venik/gps_project/doc/diplom_alex/text/diplom_task.tex

\begin{titlepage}
\newpage

\input{titles_head}		% add header

\begin{center}
\vspace{0.5cm}
\fontsize{14pt}{14.5pt}{\fontseries{b}\selectfont{ЗАДАНИЕ НА ДИПЛОМНЫЙ ПРОЕКТ} } \\
\end{center}

\begin{flushleft}
Дипломник
%\so{Никифоров}
\hrulefill \\
шифр\rule{5cm}{0.5pt} группа\rule{3cm}{0.5pt} отделение\rule{1cm}{0.5pt}\textit{дневное}\hrulefill \\

\textbf{Тема проекта}\hrulefill \\
\hrulefill \\
\hrulefill \\
\hrulefill \\
\end{flushleft}

\begin{flushleft}
Утверждена приказом по МГУПИ №\rule{2cm}{0.5pt} от «\rule{2cm}{0.5pt}»\rule{2.65cm}{0.5pt}2010г. \\
Срок представления к защите«\rule{2cm}{0.5pt}»\rule{7cm}{0.5pt}2010г. \\
\end{flushleft}

\begin{flushleft}
\textbf{Техническое задание}
\fontsize{8pt}{4.05pt}{\selectfont{(цель и постановка задачи, исходные данные для проектирования)} } \\
\hrulefill \\
\hrulefill \\
\hrulefill \\
\end{flushleft}

\begin{flushleft}
\textbf{Содержание рассчетно-пояснительной записки} \\
\textbf{Введение}
\fontsize{8pt}{8.05pt}{\selectfont{(обоснование актуальности темы)} }\hrulefill \\
\hrulefill \\
\hrulefill \\
\end{flushleft}

\begin{flushleft}
\textbf{1. Исследовательский раздел}
\fontsize{8pt}{1pt}{\selectfont{(материал по исследованию предметной области, предмета проектирования,
анализ вариантов решения задач, выбор конкретного варианта)} } \\
1.1\hrulefill \\
1.2\hrulefill \\
\end{flushleft}

\begin{flushleft}
\textbf{2. Специальный раздел}
\fontsize{8pt}{8.05pt}{\selectfont{(раскрываются все аспекты проектируемой области)} } \\
2.1\hrulefill \\
2.2\hrulefill \\
\end{flushleft}

\begin{flushleft}
\textbf{3. Технологический раздел}
\fontsize{8pt}{8.05pt}{\selectfont{(технология разработки программного, программно-аппартного, информационного
или технологического продукта)} } \\
3.1\hrulefill \\
3.2\hrulefill \\
\end{flushleft}

\begin{flushleft}
\textbf{4. Раздел по безопасности жизнидеятельности} \\
4.1\hrulefill \\
4.2\hrulefill \\
\end{flushleft}

\begin{flushleft}
\textbf{5. Организационно-экономический раздел} \\
5.1\hrulefill \\
5.2\hrulefill \\
\end{flushleft}

\begin{flushleft}
\textbf{6. Другие разделы проекта}
\fontsize{8pt}{8.05pt}{\selectfont{(Конструкторский, методический, и т.п., в т.ч. сопровождение разработанного в дипломном
проекте программного (математического, аппаратного или иного) обеспечения)} } \\
6.1 Руководство пользователя \\
6.2 Руководство программиста \\
6.3 Руководство системного администратора \\
\end{flushleft}

\begin{flushleft}
\textbf{7. Научная новизна и практическая значимочть проекта}\hrulefill \\
\hrulefill \\
\hrulefill \\
\end{flushleft}

\begin{flushleft}
\textbf{8. Перечень графического материала}
\fontsize{8pt}{8.05pt}{\selectfont{(рисунки, фотографии, чертежи, графики, и прочие иллюстрации, обязательные к представлению
в ходе защиты в электронном виде)} } \\
8.1\hrulefill \\
8.2\hrulefill \\
\end{flushleft}

\begin{flushleft}
\textbf{Консультанты по разделам}\hrulefill \\
\hrulefill \\
\hrulefill \\
\end{flushleft}

% consultants
\begin{flushleft}
\hspace{1.5cm} Экономическому 			\hspace{2.7cm} \rule{2.9cm}{0.5pt} \hspace{2cm} \rule{4.0cm}{0.5pt} \\

${a^{rподпись}}$ \hspace{2cm} ${a^{инициалы и фамилия}}$ \\

\hspace{0cm} Безопасность жизнидеятельности	\hspace{0.5cm} \rule{2.9cm}{0.5pt} \hspace{2cm} \rule{4.0cm}{0.5pt} \\
\hspace{1.7cm} другие разделы 			\hspace{2.8cm} \rule{2.9cm}{0.5pt} \hspace{2cm} \rule{4.0cm}{0.5pt} \\
\hspace{1.0cm} Руководитель проекта 		\hspace{2.0cm} \rule{2.9cm}{0.5pt} \hspace{2cm} \rule{4.0cm}{0.5pt} \\
\hspace{1.7cm} Нормоконтроль 			\hspace{2.8cm} \rule{2.9cm}{0.5pt} \hspace{2cm} \rule{4.0cm}{0.5pt} \\

\hspace{0.5cm} \textit{Задание принял к исполнению} \hspace{0.7cm} \rule{2.9cm}{0.5pt} \hspace{2cm} \rule{4cm}{0.5pt} \\

\end{flushleft}

\end{titlepage}
