venik/gps_project/doc/diplom_alex/text/titles_head.tex

% title page with the name of the university

\begin{center}
\textbf{Федеральное агентство по образованию} \\
\vspace{0.5cm}
\fontsize{12pt}{12.5pt}{\fontseries{b}\selectfont{Государственное образовательное учреждение высшего профессионального образования} }\\
\fontsize{12pt}{12.5pt}{\fontseries{b}\selectfont{“Московский государственный университет приборостроения и информатики”} }\\*
%\hrulefill
\end{center}

\begin{center}
Факультет\rule{2cm}{0.5pt}\textit{ИТ}\rule{2cm}{0.5pt} Направление \rule{2.8cm}{0.5pt} 230105\rule{2.8cm}{0.5pt} \\

\mbox{Кафедра \textit{ИТ-6 «Управление и моделирование систем»} Квалификация \textit{инженер} } \\

\end{center}

\begin{flushright}
\textit{Утверждаю} \\
Зав. кафедрой \\
\rule{2.9cm}{0.5pt} Мацнев А.П. \\
«\rule{1cm}{0.5pt}»\rule{3cm}{0.5pt} 2010г.
\end{flushright}

%\vfill
