venik/gps_project/doc/diplom_alex/text/main_special.tex

\input{main_default}	% main tamplate 

\begin{document}
%\tableofcontents 				% это оглавление, которое генерируется автоматически
%\newpage
\input{special}					% специальный раздел 
\input{bibl}					% 
\end{document}
