venik/gps_project/doc/diplom_alex/text/main.tex

\input{main_default}	% main tamplate 

\begin{document}
%\input{title}					% это титульный лист
%\input{diplom_task}
\tableofcontents 				% это оглавление, которое генерируется автоматически
\newpage
\input{intro}					% введение 
\input{research}				% исследовательский раздел 
\input{special}					% специальный раздел 
\input{tech}					% технологический раздел 
\input{bjd}					% архиважно биля 
\input{economic}				% экономический раздел 
\input{other}					% хзн раздел 
\input{outro}					% заключение 
\input{bibl}					% 
\end{document}
