venik/gps_project/doc/diplom_alex/text/main_tech.tex

\input{main_default}	% main tamplate 

\begin{document}
\tableofcontents 				% это оглавление, которое генерируется автоматически
\newpage
\input{tech}					% специальный раздел 
\input{bibl}					% 
\end{document}
