venik/gps_project/doc/diplom_alex/text/title.tex

\begin{titlepage}
\newpage

\input{titles_head}			% add header

\begin{center}
\textbf{\Large ПОЯСНИТЕЛЬНАЯ ЗАПИСКА \\
к дипломному проекту на тему: }
\end{center}

\vfill\vfill

\begin{center}
\textsc{\textbf{ничо не секу\linebreak ваще}}
\end{center}

\vfill\vfill

\begin{flushleft}
Дипломник \hrulefill Никифоров А.А \\
Группа \hrulefill   шифр \hrulefill \\
Обозначение проекта (работы) \hrulefill \\
\vfill
\textbf{Руководитель проекта (работы) \hrulefill}
\vfill
\begin{center}
Консультанты по разделам:
\end{center}
Наименование разделов: \\
\hrulefill \\
\hrulefill \\
\hrulefill \\
Нормоконтроль \hrulefill \\
\end{flushleft}

\vspace{\fill}

\begin{center}
Москва 2010г.
\end{center}

\end{titlepage}
