venik/gps_project/doc/main/main.pdf

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

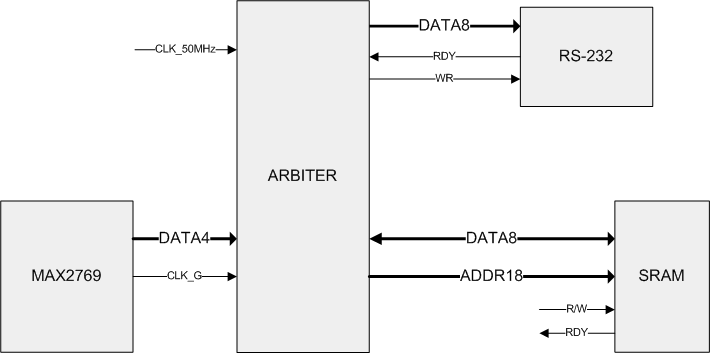
[picture p1: figure]
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
