venik/gps_project/src/hardware/board/xilinx_gps/xilinx_lab3.xls

 |  |  |  |  |  |  |  |  |  |  |  |  |  |  | ИЗМ.
ЗАКАЗЧИК |  |  |  |  |  |  |  |  |  |  |  |  |  | вер. 13.10.07
Название фирмы (или ФИО) - заказчика |  |  |  |  |  | ИНН\КПП |  | Мельников Алексей Олегович
Плательщик (если различно с заказчиком) |  |  |  |  |  | ИНН\КПП
Адрес (юридический)
Телефон / Факс |  |  |  |  |  |  |  | 8(916) 509-4286
e-mail |  |  |  |  |  |  |  | a.melnikov@samsung.com
Контактное лицо |  |  |  |  |  |  |  | Мельников Алексей Олегович
Способ доставки |  |  | Адрес доставки |  |  |  |  | Москва |  | г. Москва,ул. Часовая, д. 24, 8(916) 716-9413, Наталья
Характеристика проекта |  |  |  |  |  |  |  | Все значения и требования отличные от стандартных необходимо дописывать в поле "ДОПОЛНИТЕЛЬНЫЕ ТРЕБОВАНИЯ"
Название файла платы: |  |  |  |  |  |  |  | xilinx_lab3.pcb
Тип заказа |  |  |  |  |  |  |  | Новый
Вариант производства |  |  |  |  |  |  |  | Срочное изготовление(2-4дня)
Количество, шт. |  |  |  |  |  |  |  | 2
Размер платы (длина), мм |  |  |  |  |  |  |  | 185.0
Размер платы (ширина), мм |  |  |  |  |  |  |  | 134.0
Общая площадь платы, дм*дм (вычисляется автоматически) |  |  |  |  |  |  |  | 2.479
Формат файлов |  |  |  |  |  |  |  | P-CAD200x
Общая толщина платы, мм (по умолчанию 1,5мм) |  |  |  |  |  |  |  | 1.50
Толщина фольги, мкм (по умолчанию 18мкм) |  |  |  |  |  |  |  | 18
Количество слоев |  |  |  |  |  |  |  | 2
Наличие маски |  |  |  |  |  |  |  | с 2 сторон
Наличие маркировки краской |  |  |  |  |  |  |  | Только сверху
Переходные отверстия (по умолчанию закрыты маской) |  |  |  |  |  |  |  | Закрыты маской
Масштаб изготовления фотошаблона |  |  |  |  |  |  |  | 1:1
Мехобработка контура (по умолчанию на выбор производства)
Электроконтроль |  |  |  |  |  |  |  | нет
Монтаж в нашей фирме |  |  |  |  |  |  |  | нет
Дополнительные требования
Перечень технологических слоев (предполагается описание максимум 5 проектов при одинаковой структуре слоев)
Указать, какие характеристики каждого слоя включить в вашем проекте, пометить любым знаком
Верхний |  | Нижний |  | Маска верх |  | Маска низ |  | Шелкография верх |  |  | контур
Top | X | Bottom | X | MaskTop | X | MaskBot | X | SilkTop | X |  | Border | X
RefDes |  | RefDes |  | Pad | X | Pad | X | RefDes | X
Type |  | Type |  | RefDes |  | RefDes |  | Type
Value |  | Value |  | Type |  | Type |  | Value
 |  |  |  | Value |  | Value
 |  |  |  |  |  |  |  |  |  |  |  |  | другие слои не указанные выше, (если есть или отличаются)
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
