venik/gps_project/(list of files, drawings)

Other design files:
src/hardware/board/cypressgps/cypressgps.pcb
src/hardware/board/xilinx_usb/xilinx_usb.pcb
