venik/gps_project/(commit log)

2009-06-04 SRAM: rename sample and add some the port specification
2009-06-11 SRAM: sram controller, some fix in ucf file
    [sram.vhd]
2009-06-11 SRAM: fix sample
2009-06-11 SRAM: fix for right timing of real chip
    [sram.vhd]
2009-07-14 sram: some fixes for testing in Active HDL
    [sram.vhd]
2009-07-14 arbiter: add arbiter for rs232 conversation and arbiter for current test purposes
2009-07-31 ca_generate: Restructurisation. Fix bugs. Generate sin for one samples
2009-07-31 initial commit for board design file
    [xilinx_lab3.pcb, xilinx_lab3.sch]
2009-08-03 test: sample gui
2009-08-03 doc: just update current state
2009-08-07 top_level: redesign all code
    [arbiter.vhd, top_level.vhd]
2009-08-07 board: start drc
    [xilinx_lab3.pcb, xilinx_lab3.sch]
2009-08-10 board final checking
    [xilinx_lab3.pcb]
2009-08-10 gui: add a trace part. very cute now
2009-08-11 arbiter, top_level, sram, test_sram: add MUX, fix all errors, work on it
    [arbiter.vhd, sram.vhd, test_sram.vhd, top_level.vhd]
2009-08-11 arbiter, sram, test_mem: fix with multiple connection on the OE and WE
    [arbiter.vhd, test_sram.vhd, top_level.vhd]
2009-08-11 added ethernet tx, checking other components
    [xilinx_lab3.pcb, xilinx_lab3.sch]
2009-08-11 gui: rm Iwidgets prototype
2009-08-12 one via left for VCC_D net
    [xilinx_lab3.pcb, xilinx_lab3.sch]
2009-08-12 board: VCC_D via added
    [xilinx_lab3.pcb, xilinx_lab3.sch]
2009-08-13 board: drc done
    [xilinx_lab3.pcb, xilinx_lab3.sch]
2009-08-14 switch to 64 bit incomming command and 8 bit answer from board, check it. Now rs232 check command work fine
2009-08-15 board: move and archive the gps starter kit manual
2009-08-15 gui: finish first stage of connection with dumper, improve code - switch to FSM
2009-08-15 gui: add connection status on status frame
2009-08-15 rs232: switch to the new design, sync with gui
2009-08-16 rs232: switch the dumper to use poll()
2009-08-16 gui: fix some problems and some traces with SET_PORT
2009-08-18 arbiter, rs232: some test with command PC->Board
2009-08-18 rs232, gui: add TEST_RS232 command in dumper, and fix one parameter in the gui
    [rs232_dumper.h]
2009-08-18 rs232: add hex-trace and some fiz into poll, now i can use it for COM-port conversation
2009-08-18 gui: trace fix
2009-08-18 rs232: add conversation with the Board
2009-08-19 doc: start collecting BOM for xilinx_lab3 board
    [bom_xilinx_lab3.xls]
2009-08-24 board: bom updated
2009-08-24 board: fix problems with git
    [sram.vhd]
2009-08-25 board: components values revised
    [bom_xilinx_lab3.xls, xilinx_lab3.pcb, xilinx_lab3.sch]
2009-08-26 board: component values revised
    [bom_xilinx_lab3.xls, xilinx_lab3.pcb, xilinx_lab3.sch]
2009-09-01 bom & some component's values updated
    [bom_xilinx_lab3.xls, xilinx_lab3.pcb, xilinx_lab3.sch]
2009-09-03 board: matlab script added, bom updated
    [bom_xilinx_lab3.xls, xilinx_lab3.pcb, xilinx_lab3.sch]
2009-09-14 board: update values
2009-09-18 gps: work on startup the board
2009-10-20 rs232: small fixes =)
    [rs232_tx_new.vhd]
2009-10-21 rs232: ive kicked ass the all bugs in rs232 module
    [arbiter.vhd, rs232_rx_new.vhd, rs232_tx_new.vhd, top_level.vhd]
2009-10-24 rs232: fix in the rx module
    [rs232_rx_new.vhd]
2009-10-24 rs232: switch to the 64 bits command
2009-10-24 arbiter: restore after fix the rs232 module
    [arbiter.vhd]
2009-11-01 fix some unnede code and comments
    [gps_serial.vhd, sram.vhd]
2009-11-21 gps: fix the code
    [arbiter.vhd, gps_main.vhd, test_sram.vhd]
2009-11-21 test: fix open mode
    [rs232_ttool.c]
2009-11-25 gps: connect LD to point in the digit led
2009-12-03 arbiter: fix some bugs in the zer000 code
    [arbiter.vhd]
2009-12-04 arbiter: some fixes, cleanup the code
    [arbiter.vhd, test_sram.vhd]
2009-12-14 test: fix some code
    [gps_registers.h, rs232_ttool.c]
2009-12-23 test: FIXME - CHECK THIS REGISTER
    [rs232_ttool.c]
2009-12-25 system: get rid from reset
    [arbiter.vhd, gps_main.vhd, rs232_rx_new.vhd, rs232_tx_new.vhd, sram.vhd, top_level.vhd]
2009-12-25 test: fix the header
    [rs232_ttool.c]
2010-01-31 update current state
2010-01-31 bd: work on the gui thread
2010-01-31 bd: add gui thread
2010-01-31 bd: add rs232 thread
2010-02-01 bd: fix the exit code from threads
    [board_daemon.c, board_daemon.h, gui_server.h, rs232_dumper.h]
2010-02-02 board: board design xilinx_gps added
    [xilinx_lab3.pcb, xilinx_lab3.sch, xilinx_lab3.xls]
2010-02-02 board: mount via, debug_outs added, lines to LED removed
2010-02-02 board: xilinx_gps.pcb and sch added
    [xilinx_gps.pcb, xilinx_gps.sch]
2010-02-02 bd: add sample config
2010-02-02 trace: add one macros
2010-02-03 bd: fix init part
    [board_daemon.c, rs232_dumper.h]
2010-02-04 board: tcxo added
    [xilinx_gps.pcb, xilinx_gps.sch]
2010-02-04 board: TCXO
    [xilinx_gps.pcb, xilinx_gps.sch]
2010-02-07 board: rev 1.0 is done
    [xilinx_gps.pcb, xilinx_gps.sch, xilinx_lab3.pcb, xilinx_lab3.sch]
2010-02-07 board: docs added for usb chip
2010-02-07 board: usb revision started
    [xilinx_usb.pcb, xilinx_usb.sch]
2010-02-10 board: FT2232 modified
    [xilinx_usb.sch]
2010-02-10 doc: FT2232 pins xls file added
    [FT2232HT_pins.xls]
2010-02-10 board: FT2232H
    [xilinx_usb.pcb, xilinx_usb.sch]
2010-02-16 board: working on usb revision
    [xilinx_usb.pcb, xilinx_usb.sch]
2010-02-17 board: working on usb
    [xilinx_usb.pcb, xilinx_usb.sch]
2010-02-19 board: working on USB & ethernet
    [xilinx_usb.pcb, xilinx_usb.sch]
2010-04-12 ca_generate: add noise, filter, scaling. Restructurisation dump file
2010-06-23 board_daemon: create callback for writing mode
2010-07-17 gpstool: fix walking window test, now we have tested coarse acq, fine freq and phase correction, on test signal shoft less than 5 Hz. save it for article
2010-08-04 board:USB draft version
    [xilinx_usb.pcb, xilinx_usb.sch]
2010-08-05 board: USB release candidat 1
    [xilinx_usb.pcb, xilinx_usb.sch]
2010-08-06 board: USB release candidat 2, LED connected
    [xilinx_usb.pcb, xilinx_usb.sch]
2010-10-29 board_daemon: work on binary dump
2010-10-29 board_daemon: add GPL
2010-10-30 board_daemon: fix with banner size
    [board_daemon.h, rs232_dumper.h]
2010-10-31 board_daemon: work on binary representation
2012-09-13 initial commit of cypressgps
    [cypressgps.pcb, cypressgps.sch]
2012-09-14 library modified
    [cypressgps.pcb, cypressgps.sch]
2012-11-30 glue logic
    [cypressgps.pcb, cypressgps.sch]
2012-12-01 board: glue logic
    [cypressgps.sch]
2012-12-15 board: update
    [cypressgps.pcb, cypressgps.sch]
2013-01-30 board_cypress: pa pins used instead of I2C
    [cypressgps.sch]
2013-01-30 board: usb mini
2013-01-31 board_cypress: USB-B replaced to USB-MINI
    [cypressgps.pcb, cypressgps.sch]
2013-02-01 board: updated
    [cypressgps.pcb]
2013-02-13 board: update cypressgps
    [cypressgps.pcb, cypressgps.sch]
2013-02-19 board: almost all parts are placed
    [cypressgps.pcb, cypressgps.sch]
2013-02-20 board: start routing proc<-->MAX2769
    [cypressgps.pcb, cypressgps.sch]
2013-02-21 board: cypress processor moved to top of board
    [cypressgps.pcb, cypressgps.sch]
2013-03-07 board: copper pours added for 3.3v and GND
    [cypressgps.pcb, cypressgps.sch]
2013-03-08 board: external pads
    [cypressgps.pcb, cypressgps.sch]
2013-03-11 board: updated
2013-03-13 board: pre-DRC version
    [cypressgps.pcb, cypressgps.sch]
2013-03-14 board: SLOE/SLWR/FIFO pulled up/down. DRC done
    [cypressgps.pcb, cypressgps.sch]
2013-03-15 board: v1 complete. project transfered to rezonit
    [cypressgps.pcb, cypressgps.sch]
2013-03-18 board: shorted nets +5, PBx fixed
    [cypressgps.pcb]
2013-03-29 board: fixed GND bug, added ground for RESERVED pin
    [cypressgps.pcb, cypressgps.sch]
2013-04-22 added pull-up resistor for #wakeup
    [cypressgps.pcb, cypressgps.sch]
